RyanAkerley/MPS/design/MPS latex source code/Expo Proceedings LaTex Template/app_screenshot.jpg

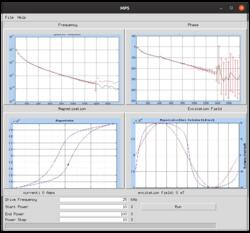
design/MPS latex source code/Expo Proceedings LaTex Template/app_screenshot.jpg
