RyanAkerley/MPS/README.md

# MPS
Software for controlling a magnetic particle spectrometer
