RyanAkerley/MPS/design/MPS latex source code/Expo Proceedings LaTex Template/budget.pdf

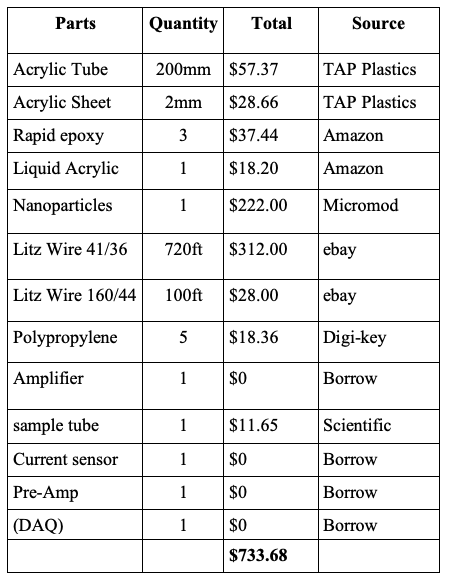
[picture p2: figure]
