RyanAkerley/MPS/design/MPS latex source code/Expo Proceedings LaTex Template/Control.pdf

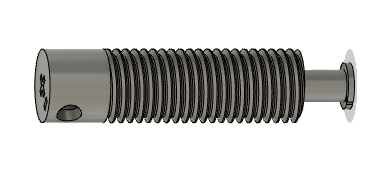
[picture p3: page 1]
