RyanAkerley/MPS/design/MPS latex source code/Expo Proceedings LaTex Template/inductor.pdf

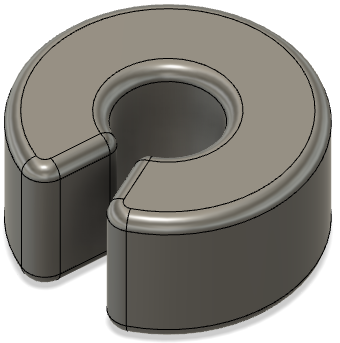
[picture p4: page 1]
