RyanAkerley/MPS/design/MPS latex source code/Expo Proceedings LaTex Template/Receiving.pdf

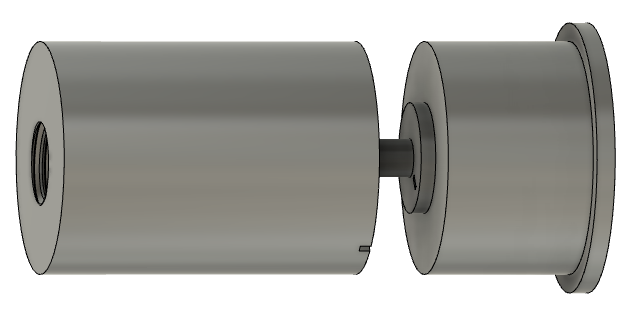
[picture p5: page 1]
