RyanAkerley/MPS/design/MPS latex source code/Expo Proceedings LaTex Template/UMBELOGO-eps-converted-to.pdf

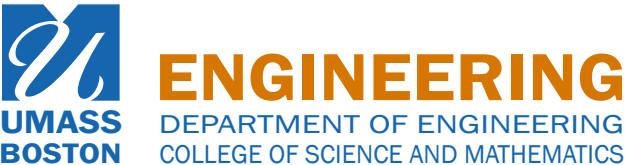
[picture p6: figure]
BOSTON; UMASS; COLLEGE OF SCIENCE AND MATHEMATICS; ENGINEERING; DEPARTMENT OF ENGINEERING
