RyanAkerley/MPS/design/MPS latex source code/Expo Proceedings LaTex Template/Diagram.jpg

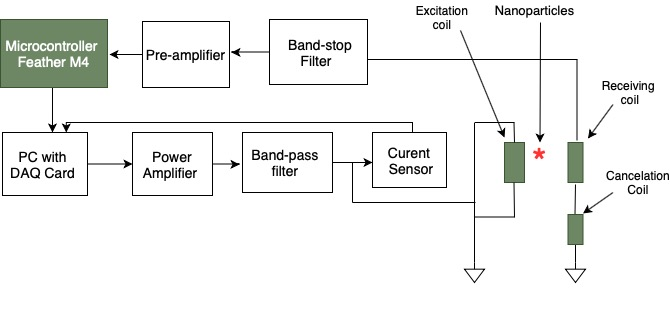
design/MPS latex source code/Expo Proceedings LaTex Template/Diagram.jpg
