RyanAkerley/MPS/(list of files, cad)

Other CAD files:
design/Receive and control coil /Final with screw driver.f3d
design/Receive and control coil /Final without screw.f3d
design/Receive and control coil /New Version.f3d
design/inductor for banpass fliter /INDUCTOR L1, L2.f3d
