RyanAkerley/MPS/design/MPS latex source code/Expo Proceedings LaTex Template/Diagram.pdf

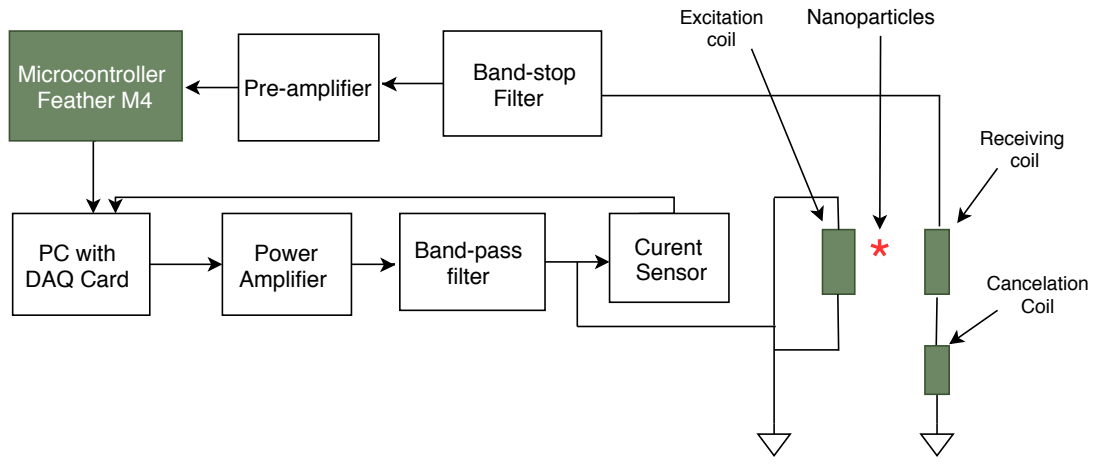
[picture p8: page 1]
Microcontroller Feather M4; Band-pass filter; PC with DAQ Card; Band-stop; Power Amplifier; Curent Sensor; Excitation; Nanoparticles; coil; Receiving coil; Cancelation Coil

Filter Pre-amplifier
