RyanAkerley/MPS/design/filters/Bandpass_Excitation.asc

C1: cap; 2µ; V=4 Irms=162m Rser=0.395426 Lser=0 mfg="KEMET" pn="C0402C103K7PAC" type="X5R"
C2: cap; 8µ; Rser=8.3m
C3: cap; 0.68µ; Rser=1m
L1: ind; 17µ; Rser=.2914
L2: ind; 64µ; Rser=.415
R1: res; 0.1
Rsrc: res; 4
Transmit_Coil: ind; 50.3m
Vsource: voltage; SINE(0 1 25k 0 0 0); AC 1; Rser=0
Named nets: 0, V1, V2, V3, in, out
.ac dec 5k 1k 100k
