RyanAkerley/MPS/design/filters/Bandstop receiving .asc

C1: cap; .122µ
L1: ind; 330µ
Lcoil: ind; 2.25µ
Rs: res; 50
V1: voltage; SINE(1 1 500k 0 0 0); AC 1; Rser=0
Named nets: 0, Vout, vin
.ac dec 5k 1k 500k
